annanedelcu/Nod-senzorial/MiWi1.brd

## EAGLE design MiWi1.brd (2014-04-13)

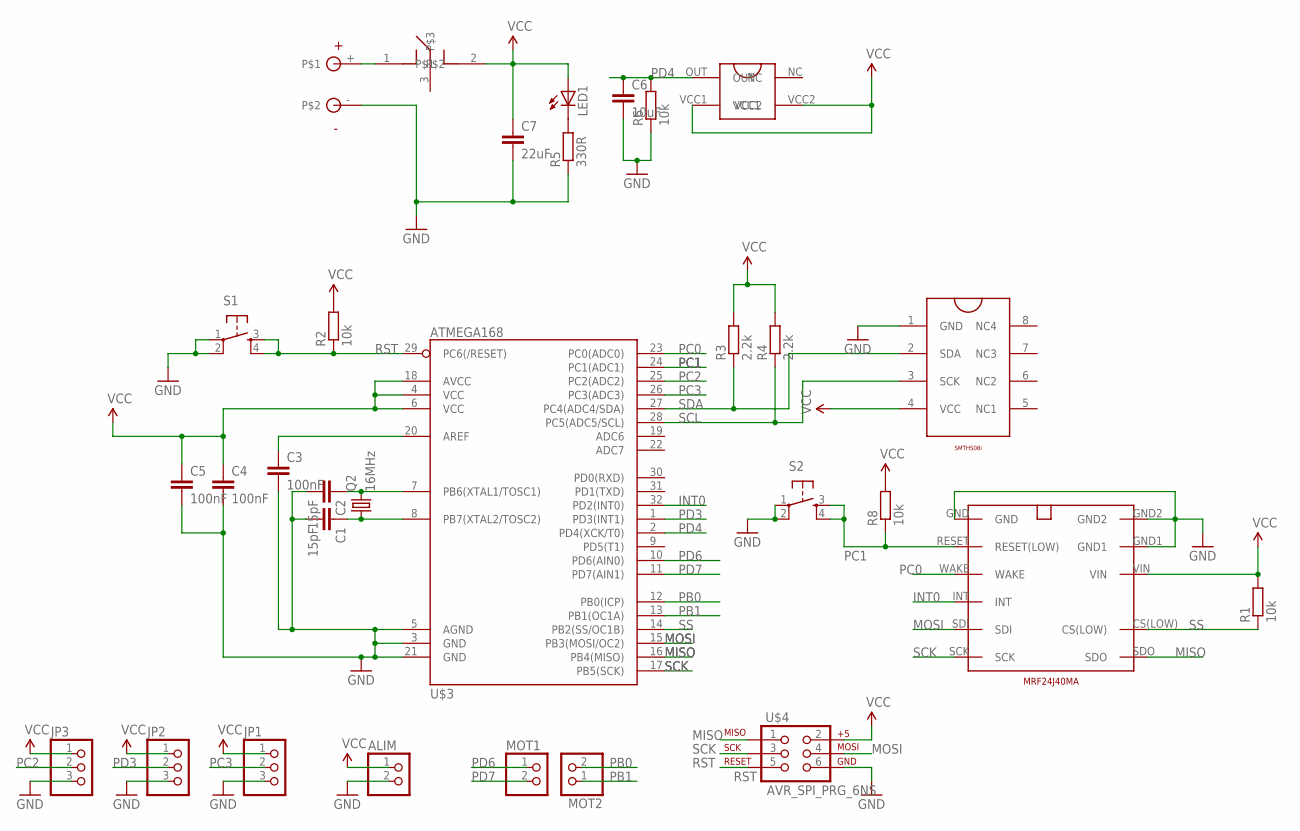
[picture p1: schematic MiWi1.sch]

Parts:
ALIM: PINHD-1X2; 1X02
C1, C2: 15pF; C0805
C3, C4, C5: 100nF; C0805
C6: 10uF; C0805
C7: 22uF; C0805
JP1, JP2, JP3: PINHD-1X3; 1X03
LED1: LEDCHIP-LED0805; CHIP-LED0805
MOT1, MOT2: PINHD-1X2; 1X02
Q2: 16MHz; CRYSTAL-SMD-5X3
R1, R2, R6, R8: 10k; R0805W
R3, R4: 2.2k; R0805W
R5: 330R; R0805W
S1, S2: TAC_SWITCHSMD; TACTILE_SWITCH_SMD
U$1: MRF24J40MA
U$2: SMTH08I; SMTHS08I_PK
U$3: ATMEGA168; TQFP32-08
U$4: AVR_SPI_PRG_6NS; 2X3-NS
U$5: SPDT_PCM12SMRT
U$6: 2XAAA_BATTERY_HOLDER
U$7: APDS-9004

Connections:
GND: ALIM.2, C1.2, C2.2, C3.2, C4.2, C5.2, C6.2, C7.2, JP1.3, JP2.3, JP3.3, R5.1, R6.1, S1.1, S1.2, S2.1, S2.2, U$1.GND, U$1.GND1, U$1.GND2, U$2.1 (GND), U$3.3 (GND), U$3.5 (AGND), U$3.21 (GND), U$4.6, U$6.-
INT0: U$1.INT, U$3.32 (PD2(INT0))
MISO: U$1.SDO, U$3.16 (PB4(MISO)), U$4.1
MOSI: U$1.SDI, U$3.15 (PB3(MOSI/OC2)), U$4.4
unnamed: C2.1, Q2.3 (2), U$3.7 (PB6(XTAL1/TOSC1))
unnamed: C1.1, Q2.1, U$3.8 (PB7(XTAL2/TOSC2))
unnamed: C3.1, U$3.20 (AREF)
unnamed: U$5.1, U$6.+
unnamed: LED1.C, R5.2
PB0: MOT2.2, U$3.12 (PB0(ICP))
PB1: MOT2.1, U$3.13 (PB1(OC1A))
PC0: U$1.WAKE, U$3.23 (PC0(ADC0))
PC1: R8.1, S2.3, S2.4, U$1.RESET (RESET(LOW)), U$3.24 (PC1(ADC1))
PC2: JP3.2, U$3.25 (PC2(ADC2))
PC3: JP1.2, U$3.26 (PC3(ADC3))
PD3: JP2.2, U$3.1 (PD3(INT1))
PD4: C6.1, R6.2, U$3.2 (PD4(XCK/T0)), U$7.OUT
PD6: MOT1.1, U$3.10 (PD6(AIN0))
PD7: MOT1.2, U$3.11 (PD7(AIN1))
RST: R2.1, S1.3, S1.4, U$3.29 (PC6(/RESET)), U$4.5
SCK: U$1.SCK, U$3.17 (PB5(SCK)), U$4.3
SCL: R4.1, U$2.3 (SCK), U$3.28 (PC5(ADC5/SCL))
SDA: R3.1, U$2.2 (SDA), U$3.27 (PC4(ADC4/SDA))
SS: R1.1, U$1.CS(LOW), U$3.14 (PB2(SS/OC1B))
VCC: ALIM.1, C4.1, C5.1, C7.1, JP1.1, JP2.1, JP3.1, LED1.A, R1.2, R2.2, R3.2, R4.2, R8.2, U$1.VIN, U$2.4 (VCC), U$3.4 (VCC), U$3.6 (VCC), U$3.18 (AVCC), U$4.2, U$5.2, U$7.VCC1, U$7.VCC2

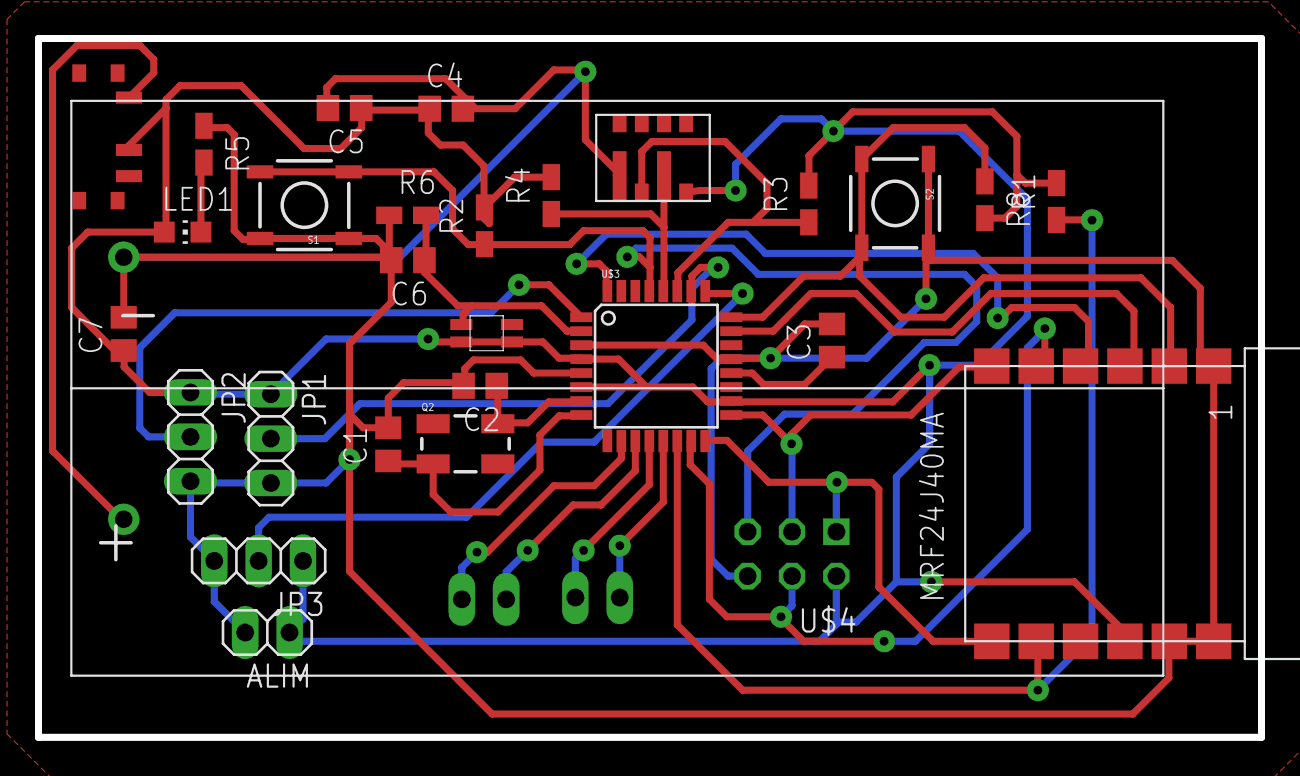
[picture p2: board MiWi1.brd from above]

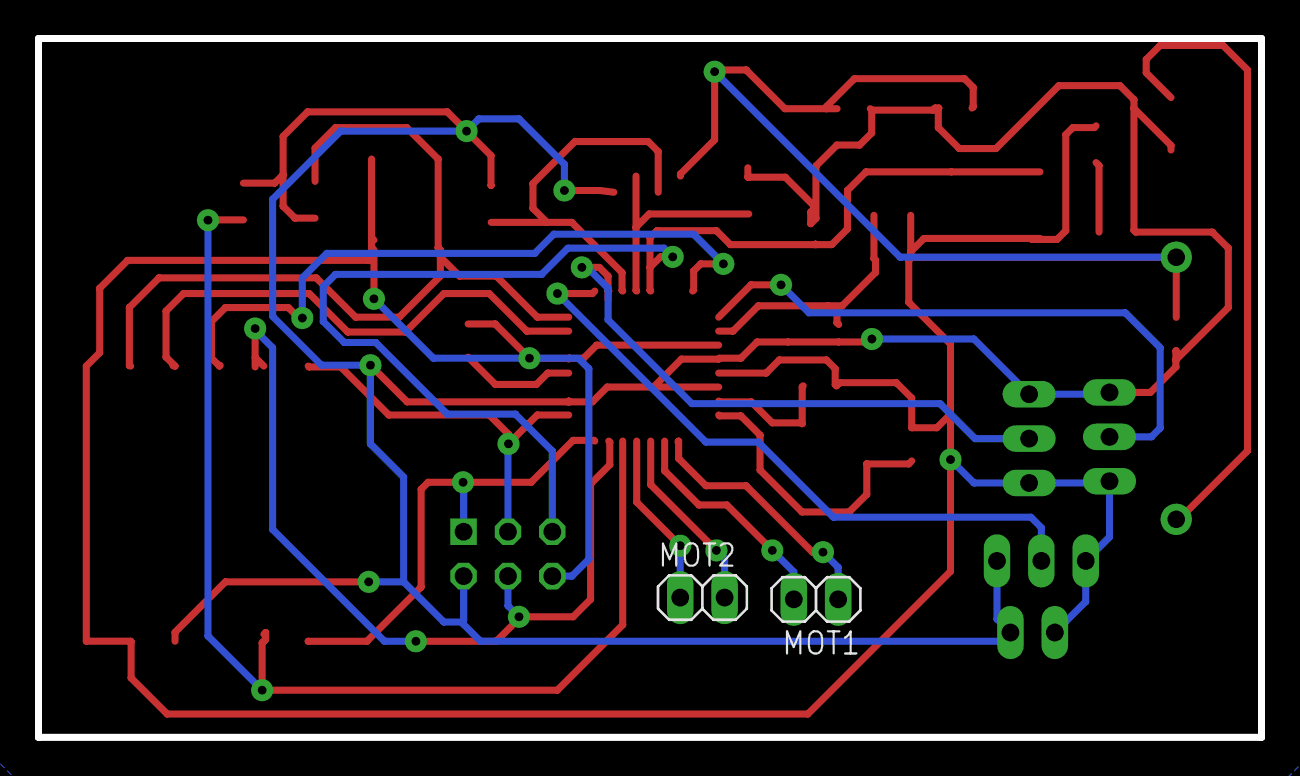
[picture p3: board MiWi1.brd from below]

Board: 2 copper layers, 70.0 x 40.0 mm, 31 parts (2 on the bottom side), 25 nets.
