annanedelcu/Nod-senzorial/EAH_0413_Print_MiWi.pdf

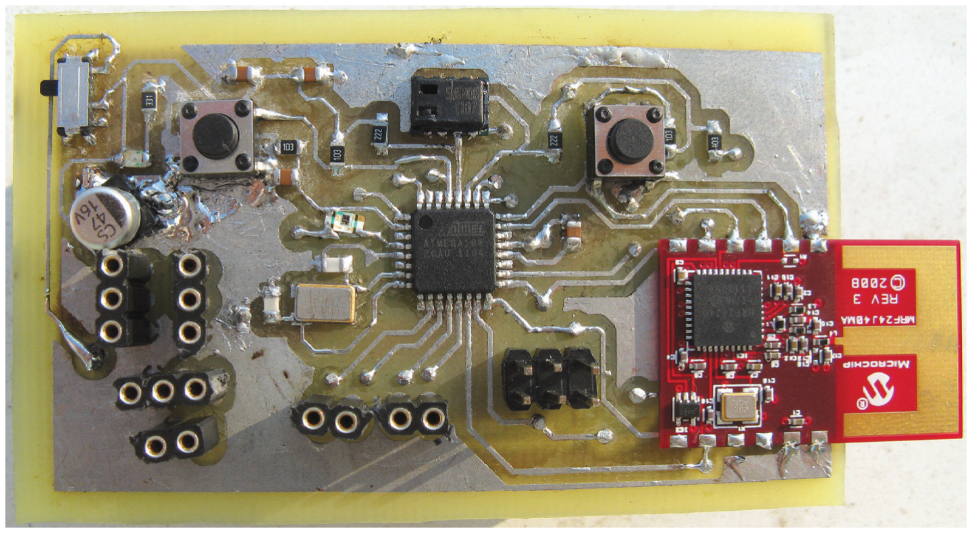
[picture p8: figure]
