annanedelcu/Nod-senzorial/EAH_0413_Print_MiWi.pdf

Electronica Azi HOBBY • Septembrie, 2013 • Nr. 4

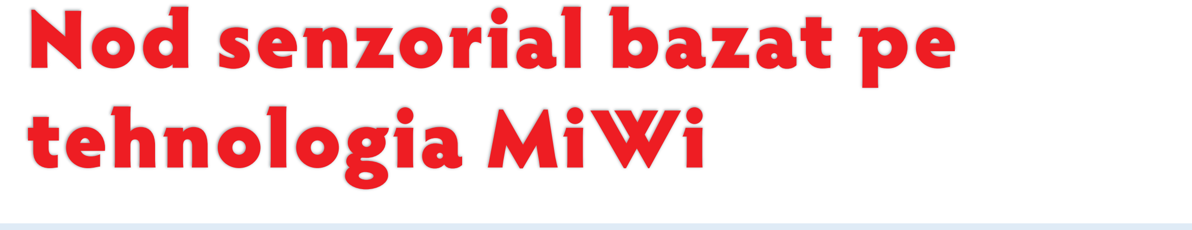
[picture p4: figure]
Nod senzorial bazat pe tehnologia MiWi

6

În această eră, în care internetul a devenit un "obiect” atât de comun, iar informația circulă prin aer atât de ușor, se pare că device-urile care facilitează acest lucru au devenit cele mai căutate. Astfel, toți putem avea tot ceea ce ne dorim fără a ne deplasa pe distanțe prea mari și se pot crea lucruri care acum doar 10 ani făceau cu totul parte din sfera Science-fiction.
Mulți sunt cei care au auzit de tehnologia WiFi - rutere bazate pe WiFi; folosim acum majoritatea dintre noi acasă, la serviciu, la facultate... și chiar și prin stațiile de metrou și restaurante. Însă fiți foarte atenți, pentru că

există și alte tehnologii care facilitează transmiterea informației “prin aer”. Una dintre acestea se numește MiWi și este realizată de cei de la Microchip, firmă renumită pentru device-urile realizate în acest domeniu.
Și acum să presupunem că am vrea să folosim această tehnologie.
Ce funcționalități i-am putea găsi? O idee ar fi să facem un nod senzorial - o plăcuță care să citească temperatura, nivelul de umiditate și cel de lumină dintr-un anumit loc și toate aceste informații ar putea fi monitorizate de la un calculator. Sau am putea să realizăm un fel de telecomandă pentru un roboțel (eventual unul care să ne aducă micul dejun la pat ☺). Sau am putea să le facem pe amândouă.
Așa că am realizat un modul care să îndeplinească într-un fel funcționalitățile de mai sus. Modulul conține senzori utili pentru anumite măsurători, dar este de asemenea realizat astfel încât să poată fi conectat la un roboțel, care poate fi programat să acționeze autonom, sau poate fi controlat printr-un calculator.

Componentele importante ce alcătuiesc acest modul sunt: microcontrolerul (Atmega
168) modulul MiWi - MRF24J40MA, senzori de umiditate, de temperatură și de lumină. Cei doi senzori vor citi date din mediu și prin intermediul microcontrolerului și apoi al modulului MiWi, se vor transmite aceste date unui server pentru a putea fi folosite de către utilizator.
În ceea ce privește folosirea plăcuței cu un robot, ea a fost proiectată pentru a intra în componența unor roboței numiți HexBug Spiders, care inițial puteau fi telecomandați prin IR, dar cu ajutorul acestui modul, pot fi transformați în roboți autonomi sau pot fi controlați de la distanțe mai mari.
E adevărat că aceștia sunt doar niște jucării, dar și modulul este un prototip, scopul lui fiind deocamdată doar demonstrativ. Astfel, prin atașarea unui senzor sharp, prin legarea driver-ului de motoare pe care aceștia îl au deja și printr-un program inteligent, “artropodele” pot fi făcute să iasă singure dintr-un labirint, iar prin uti-

În această eră, în care internetul a devenit un “obiect” atât de comun, iar informația circulă prin aer atât de ușor, se pare că device-urile care facilitează acest lucru au devenit cele mai căutate. Astfel, toți putem avea tot ceea ce ne dorim fără a ne deplasa pe distanțe prea mari și se pot crea lucruri care acum doar 10 ani făceau cu

totul parte din sfera Science-fiction.

Autor:
Ana-Florentina Nedelcu - annanedelcu@yahoo.com

HexBug Spider

Modulul MiWi

Electronica Azi HOBBY • Septembrie, 2013 • Nr. 4

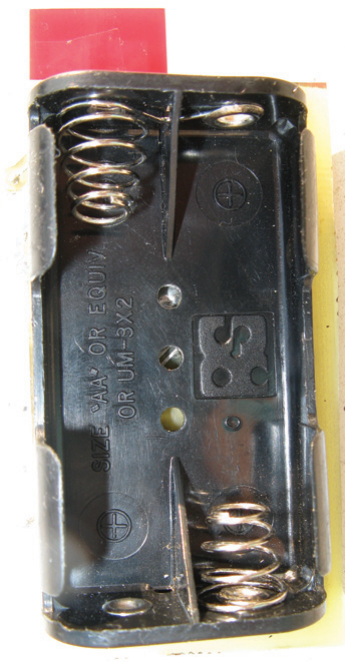
[picture p5: figure]

7

lizarea modulului MiWi de care dispune plăcuța, ele pot fi dirijate de la distanță. Schema modulului și design-ul sunt reali -zate într-un program specific, Eagle.

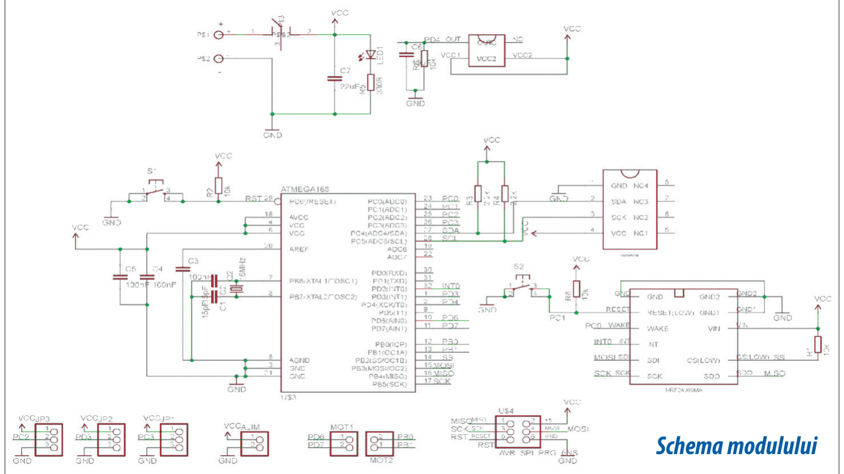
[picture p6: figure]
Schema modulului
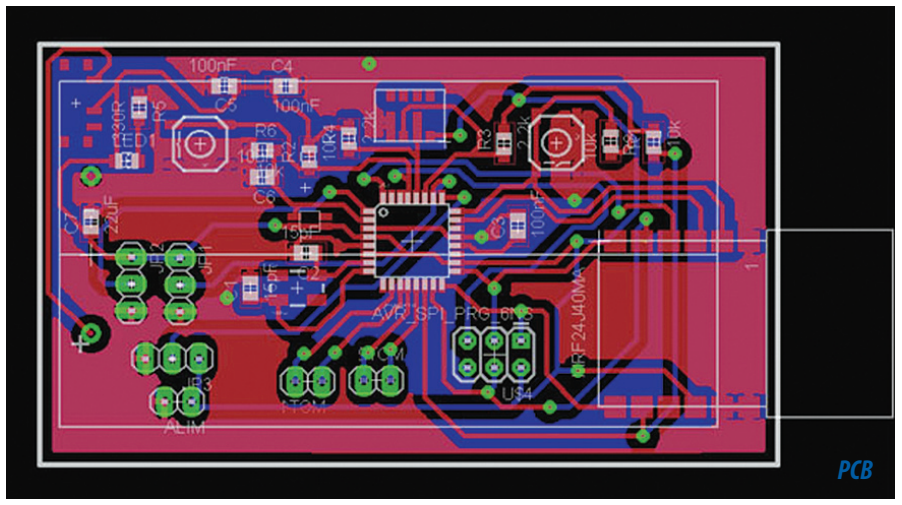
[picture p7: figure]
PCB

Modulul este alimentat de la două baterii de tip AA conectate în serie, astfel încât tensiunea de alimentare rezultată este de 3V. Aceasta este suficientă pentru modulul MiWi, microcontroler și senzori, iar alimentarea prin baterii conferă astfel autonomie modulului. Microcontrolerul este însoțit de un cristal de cuarț cu frecvența de 16MHz și poate fi programat prin ISP folosind limbajul C împreună cu bibliotecile AVR.
Modulul MiWi comunică prin interfața SPI cu microcontrolerul, dispunând de pini specifici, precum și de un pin pentru RESET și unul pentru WAKE.
Senzorul de temperatură și umiditate este SMTHS08I (senzor digital), iar cel de lumină este APDS-9004 (senzor analogic). Sunt disponibile trei seturi de pini la care pot fi conectați doi senzori analogici/ digitali și unul digital, patru pini la care pot fi conectate două motoare bidirecționale. Modulul conține și buton de ON/OFF, precum și un LED care redă starea acestuia. Schema este prezentată în figura de mai jos. Apoi am realizat design-ul (alegerea pieselor folosite și așezarea lor pe placă, astfel în cât

să aibă dimensiuni cât mai mici). Am folosit îndeosebi piese SMD, care este adevarat că implică mai multă tehnică în lipire și sunt mai sensibile, dar reduc dimensiunile semni -ficativ (rezistențele, condensoatoarele și LED-ul sunt în capsulă de 0805).

După destul de multă muncă și multă atenție în realizarea plăcuței cu trasee și lipirea pieselor pe aceasta, rezultatul este prezentat la finalul articolului.

Apoi trebuie realizată programarea modulului: întâi se realizează comunicația dintre senzori și microcontroler, apoi dintre microcontroler și modulul MiWi - au fost realizate anumite biblioteci speciale care să realizeze acest lucru, deoarece se pare că nu este chiar ușor (modulele MiWi au fost concepute astfel încât să poată comunica ușor cu un microcontroler de tip PIC, nu AVR, cum avem noi).

Senzorii vor transmite datele preluate din mediu la microcontroler și apoi către modulul MiWi care le va da și el mai departe ... către utilizator.

Este nevoie astfel de un modul MiWi conectat la o placă de rețea, care să preia informațiile de la modulul MiWi co nec tat la device-ul nostru și să le afișeze în calculator. Însă în cadrul micului nostru proiect, acest aspect s-a numărat
printre sarcinile altui
coleg de-al meu.

Ultima etapă, dar nu
cea din urmă este
programarea micro -
controlerului astfel
încât să poată prelua
date de la senzorii cu
care va fi echipat un
HexBug Spider (în
cazul nostru, un sen -
zor Sharp ana logic) și
pentru a comanda
motoarele acestuia.

Așadar, iată un device util atât celor mari, dar și celor mici ☺!

## MiWi
